willbearfruits/twofold/README.md

# TWOFOLD

A small USB sound card with an effects rack inside, a little screen and one knob.

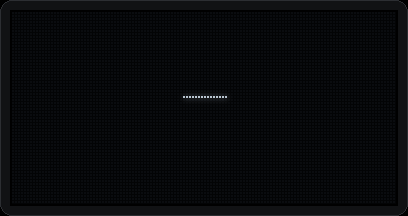
[picture p1: docs/img/ui/tour.gif]
TWOFOLD's screen as the firmware draws it: the volume page, the EQ, then each effect in turn


**[Flash it from your browser](https://willbearfruits.github.io/twofold/#flash)** ·
[Project page](https://willbearfruits.github.io/twofold/) ·
[Open the editor](https://willbearfruits.github.io/twofold/editor/) · [Get one](#get-one)

Plug it into a computer and it shows up as a stereo audio interface and a MIDI port, with nothing to install. Turn
the knob for volume. Press it to shape the sound with EQ, saturation, chorus, delay, plate reverb and a compressor,
each one drawn live on the screen. The same settings open in a web page that talks to the box over the USB cable.

## What it does

- **A sound card that needs no driver.** Stereo in and out at 48 kHz / 24-bit, plus a MIDI port, over one USB-C
  cable. It uses the audio driver built into Linux, macOS and Windows 10/11. (On the kit board the input is a
  microphone; a PCM1808 module adds a stereo line input.)
- **Effects in the box, not in the computer.** Five-band EQ, saturation, chorus, stereo or ping-pong delay, plate
  reverb and a compressor, then a safety limiter that keeps the output from clipping.
- **Easier listening.** Loudness compensation keeps the bass as you turn the volume down. Headphone crossfeed takes
  the hard edges off wide stereo mixes.
- **Hear yourself at once.** Direct monitoring mixes the input into the output without the trip through the
  computer, dry or through the effects.
- **One knob, one screen.** The EQ curve is drawn from the real filters over a live spectrum, and every effect has
  its own animation. Eight presets live on the box. (The GIF above is the firmware's own drawing code, run on a
  computer by the UI simulator.)
- **An editor in the browser.** Every setting, the meters, the presets and the MIDI map, in Chrome or Edge, over the
  USB cable. No WiFi, no app.
- **MIDI control.** Every parameter has a MIDI CC you can remap, and the knob can act as a MIDI controller.
  Bluetooth MIDI is there if you switch it on.
- **Quiet by default.** WiFi and Bluetooth stay completely off ("Studio Mode") until you ask for them.

TWOFOLD runs on the [ESP32-S3 SuperMini kit](https://github.com/willbearfruits/esp32-s3-supermini-kit), the same board
as [Samplooler](https://github.com/willbearfruits/samplooler), the looper you play by tilting it. One built board can
be flashed as either, and back again. [RING](https://github.com/willbearfruits/ring), a Raspberry Pi instrument, picks a
TWOFOLD up automatically as its sound card when one is plugged in.

## Get one

- **Buy one.** Built by hand in Haifa. There is no list price: write and ask, by
  [email](mailto:Dogme84@gmail.com?subject=TWOFOLD) or [WhatsApp](https://wa.me/972539263808). It is the same board as
  Samplooler, so ask for either, or both.
- **Build one in the workshop.** The [ESP32 workshop](https://willbearfruits.github.io/serious-shit/workshop-esp32.html):
  7 meetings at MEZO, Sirkin 3, Haifa · 2,200 ₪ · kit included · up to 8 people · 4 hours a week of open lab between
  meetings. You leave with a board that runs TWOFOLD and Samplooler.
- **Build it yourself.** Everything is open. Wire the modules from the [parts list and wiring](#hardware) below, or
  follow the kit's [assembly guide](https://github.com/willbearfruits/esp32-s3-supermini-kit/blob/main/docs/assembly/README.md):
  a kit board runs TWOFOLD unchanged.

## Flash it

You need a built board and a USB-C cable.

1. **From the browser** (Chrome or Edge on a computer): hold the board's **BOOT** button while you plug it in, then
   let go. Open the [flasher](https://willbearfruits.github.io/twofold/#flash), press **Connect and flash** and pick
   the port. When it says done, unplug and plug in again.
2. **Or with esptool:** download `twofold-v1.0.2-full.bin` from
   [Releases](https://github.com/willbearfruits/twofold/releases), enter the bootloader the same way, then

   ```sh
   esptool.py --chip esp32s3 -p /dev/ttyACM0 -b 460800 write_flash 0x0 twofold-v1.0.2-full.bin
   ```

   (Windows: `COMx`; macOS: `/dev/cu.usbmodem*`.)

Then:

- Your computer shows an audio device and a MIDI port called **TWOFOLD**. Pick it for input and output and set the
  sample rate to 48 kHz.
- On the kit board the input is the INMP441 microphone, which is mono on the left channel: set
  **GAIN → INPUT → LEFT** to hear it in both ears.
- For the editor, open **https://willbearfruits.github.io/twofold/editor/** in Chrome or Edge and press
  **Connect over USB**. On Linux, install the udev rule once:
  `sudo cp tools/99-twofold.rules /etc/udev/rules.d/ && sudo udevadm control --reload`, then replug. Windows and
  macOS should need nothing (not tested yet, see Status).
- The one-page guide for people who get a unit: [docs/QUICKSTART.md](docs/QUICKSTART.md).

Once TWOFOLD is on the board, updates need no buttons: `tools/flash.sh` asks the running firmware to reboot into
the bootloader, or, with WiFi on, the editor's **Device → Firmware** takes the `-ota.bin` file and rolls back by
itself if the new firmware fails.

## Status

Version 1.0.2, a release for testers. Tested on the ESP32-S3 SuperMini board, on Linux: USB audio in and out and
MIDI, two hours of playback with no dropouts, WiFi and Bluetooth running together, firmware updates over WiFi with
automatic rollback, hands-free flashing, and crash reports over USB. The DSP is checked by a test suite on a
computer ([results](docs/test-results/dsp_tests.md)).

Not tested yet: Windows and macOS (the device uses their built-in drivers, so it should work, but nobody has listened
on them yet), the stereo line input (PCM1808) and the low-jitter clock mode, measured noise and distortion through
real converters, and the printed case. It still uses Espressif's USB vendor ID with a placeholder product ID. The full
list is under [Needs real hardware to confirm](#needs-real-hardware-to-confirm). Reports of builds, good or bad, are
welcome in the issues.

---

## Inside

A 2-in / 2-out USB audio interface on the ESP32-S3: class-compliant UAC2 at 48 kHz / 24-bit plus USB-MIDI, an
onboard 32-bit float DSP chain, and a 128×64 OLED with one encoder. Radios are off by default ("Studio Mode").

| | |
|---|---|
| Audio | UAC2 async (explicit feedback), 48 kHz, 24-bit in 4-byte subslots, stereo in + out, driverless on Linux / macOS / Windows 10+ |
| DSP | 5-band parametric EQ (SVF/biquad hybrid) → saturation (2× oversampled) → chorus/ensemble → stereo/ping-pong delay → plate reverb → bus compressor → monitor blend → loudness compensation (ISO 226) → headphone crossfeed → volume → lookahead safety limiter → TPDF dither |
| Monitoring | zero-USB-latency direct monitor crossfade, dry or through the FX |
| Control | EC11 encoder (PCNT, accelerated), USB-MIDI CC (mappable), the web editor over **USB** (WebUSB/WinUSB, no radio) or opt-in WiFi (+ OTA), opt-in BLE-MIDI |
| Display | custom pixel fonts, live EQ curve from the real biquad coefficients + spectrum, per-effect visualisations, 60 fps tweened motion |
| Persistence | settings, MIDI map and 8 presets in NVS, written only in audio-safe windows |

Docs: [PLAN.md](PLAN.md) (architecture, clocking, budgets, every assumption and deviation) ·
[wiring](docs/wiring.md) · [clock analysis](docs/clocking/clock_jitter.md) · [DSP test results](docs/test-results/dsp_tests.md) ·
[UI design](docs/img/ui/) · [enclosure](docs/enclosure.md) · [web API](firmware/components/net/API.md) · [tools](tools/README.md) ·
[quick start](docs/QUICKSTART.md)

## Hardware

### BOM
| qty | part | notes |
|---|---|---|
| 1 | ESP32-S3 SuperMini (ESP32-S3FH4R2, 4 MB flash, 2 MB PSRAM) | native USB-C on GPIO19/20; tested target (flashed, enumerates) |
| 1 | PCM5102A module ("GY-PCM5102", purple) | XSMT bridged H, FMT=L, FLT=L, DEMP=L, SCK=GND |
| 1 | INMP441 I2S microphone (kit input) **or** PCM1808 line-in module | PCM1808: FMT=0, MD1=MD0=0 (slave, MCLK from GPIO21) or 1/1 (master, low-jitter mode) |
| (1) | MAX98357A I2S speaker amp (kit) | enabled via GPIO11 |
| 1 | 0.96" 128×64 I2C OLED (SSD1306 or SH1106, 4-pin, 0x3C) | controller selectable in Kconfig and at runtime (Settings → OLED) |
| 1 | EC11 encoder with switch, 15 mm D-shaft | 2 × 10 nF from A/B to GND recommended |
| 2 (3) | 3.5 mm stereo panel jacks (PJ-392 class, M6 bushing) | inputs (+ output if `output_jack="panel"`) |
| (1) | 12.288 MHz 3.3 V CMOS oscillator (SiT1602 / ECS-2520MV class) + 2 × 33 Ω | low-jitter mode only |
| | analog supply parts: see *Noise mitigation* | |
| | enclosure hardware: 4 × M3×20, 4 × M3 heat-set inserts, M2 screws, 4 bumpons | [docs/enclosure.md](docs/enclosure.md) |

### Wiring
All pins live in one header, [`board_config.h`](firmware/components/board/include/board_config.h). The full tables
(per module, power, strapping, both clock modes, ASCII diagrams) are generated from it into
[docs/wiring.md](docs/wiring.md) by `tools/gen_wiring.py`.

| GPIO | signal | connects to | notes |
|---|---|---|---|
| 7 | I2S BCK | PCM5102A BCK, INMP441 SCK, MAX98357A BCLK (or PCM1808 BCK) | input in low-jitter mode |
| 8 | I2S LRCK | PCM5102A LCK, INMP441 WS, MAX98357A LRC (or PCM1808 LRC) | input in low-jitter mode |
| 9 | I2S DOUT | PCM5102A DIN, MAX98357A DIN | |
| 10 | I2S DIN | INMP441 SD (or PCM1808 DOUT) | |
| 11 | AMP SD | MAX98357A SD | high once clocks are stable (pop-free start) |
| 12 / 13 | I2C SDA / SCL | OLED | shared with the kit's IMU/ToF |
| 4 / 5 / 6 | ENC A / B / SW | EC11 (C and switch leg → GND) | internal pull-ups |
| 21 | I2S MCLK | PCM1808 SCKI (only if fitted) | 12.288 MHz, internal clock mode |
| 48 | status LED | onboard RGB LED | |

This is the same wiring as the kit and Samplooler builds, so an existing kit board runs TWOFOLD unchanged.
GPIO1/2/3 stay with the kit's joystick. Avoided: strapping 0/3/45/46, USB 19/20, UART0 43/44.
The kit's input is the INMP441 microphone (mono, left slot): set **Gain → INPUT → LEFT** to hear it in both ears.
PCM5102A SCK: **GND** in internal mode (its PLL locks to BCK), **oscillator** in low-jitter mode. XSMT is bridged high
(set `BOARD_PIN_DAC_XSMT` to a free GPIO if you want a hardware soft-mute during boot).

### Enclosure
[`enclosure/twofold.scad`](enclosure/twofold.scad) is a parametric two-part wedge case with a knob, collision checks
and ready STLs ([docs/enclosure.md](docs/enclosure.md)). It was drawn around the Waveshare ESP32-S3-Zero, the board
TWOFOLD started on, and has not been printed yet. On the SuperMini kit, the board lives in the kit's own case.

## Clocking

The ESP32-S3 has no APLL, so I2S MCLK comes from a fractional divider. IDF 5.5 offers PLL_F160M, XTAL and EXTERNAL.

* **Internal mode (default):** ESP32 is I2S master, PLL_F160M → MCLK 256·fs = 12.288 MHz (divider 13 + 1/48),
  BCK = MCLK/4 exactly. The divider's error is a deterministic pattern repeating at **256 kHz**, far out of band.
  `tools/clock_jitter.py` models the IDF divider and gives 1.80 ns rms BCK jitter. That limits a full-scale 20 kHz
  sine to 72.9 dB in the raw case; after the PCM1808 decimation filter the in-band limit is 137.9 dB, and the
  PCM5102A's PLL (SCK = GND) filters what it sees. XTAL as a source is worse: 64 kHz pattern, 4× larger steps.
  Full analysis: [docs/clocking/clock_jitter.md](docs/clocking/clock_jitter.md).
* **Low-jitter mode** (`idf.py menuconfig` → TWOFOLD board → Audio clock mode → Low-jitter): a 12.288 MHz
  oscillator drives PCM1808 SCKI and PCM5102A SCK through 33 Ω resistors. The PCM1808 is I2S master (MD1=MD0=1)
  and the ESP32-S3 (TX + RX) and PCM5102A are slaves. No fractional division anywhere.
* **One clock domain:** one I2S peripheral in full duplex; TX and RX share BCK/LRCK in both modes.
* **USB feedback follows whichever clock is master:** the audio task is paced only by the I2S clock and drains
  and fills TinyUSB's FIFOs. OUT uses `AUDIO_FEEDBACK_METHOD_FIFO_COUNT` and IN uses level-based 47/48/49-frame
  flow control, so both loops track the real converter clock with nothing mode-specific to calibrate.

## Building from source

Requires ESP-IDF **v5.5.x**. Components (TinyUSB 0.21, esp-dsp, led_strip, mdns) come from the registry
(`firmware/dependencies.lock` pins them).

```sh
. ~/esp/esp-idf/export.sh
cd firmware
idf.py set-target esp32s3      # once
idf.py menuconfig              # optional: TWOFOLD board → clock mode, OLED type, I2C 1 MHz, encoder direction
idf.py build
```

Flashing: TinyUSB owns the native USB port at runtime, so enter the ROM bootloader first. Hold **BOOT**, tap
**RST**, release BOOT; the board enumerates as a USB-serial/JTAG device (`303a:1001`). Then:

```sh
idf.py -p /dev/ttyACM0 flash
```

Press RESET to start; it enumerates as **TWOFOLD** (audio + MIDI). Logs come out of UART0 (GPIO43 TX / GPIO44 RX,
115200). Later updates can also go over WiFi: Device → Firmware in the web editor (OTA, A/B partitions).

Host-side tools (no hardware needed):

```sh
host/dsp_tests/run.sh          # DSP test-suite -> docs/test-results/dsp_tests.md + plots
host/sim/run.sh                # UI simulator -> docs/img/ui/ (every screen, transitions, tour.gif)
python3 host/web_mock/server.py --port 8000   # the web editor with a fake device
enclosure/check.sh             # enclosure collision checks + STL export
python3 tools/loopback.py --selftest          # measurement-suite self-test (synthetic device)
```

### Releases
`tools/release.sh [version]` builds `dist/twofold-<version>/`: a merged image for `esptool write_flash 0x0`, the
app-only OTA image, the editor page for USB use, the udev rule, checksums, `FLASH.md` and
[docs/QUICKSTART.md](docs/QUICKSTART.md) (the one-page guide for people who get a unit). Tag releases
(`git tag -a v1.0.0`) so the version shows in ABOUT and `/api/info`. The bundle goes to
[GitHub Releases](https://github.com/willbearfruits/twofold/releases), not into the repository. The browser flasher
serves its own copy of the full image from [docs/flash/](docs/flash/), and [docs/editor/](docs/editor/) holds a copy of
the editor: update both, and `docs/flash/manifest.json`, with each release.

## Hands-free flashing, status and crash reports over USB
`tools/flash.sh` asks the running firmware (USB-MIDI SysEx) to reboot into the ROM download mode, flashes, and starts
the app again: no BOOT/RST buttons after the first flash. `tools/twofold_status.sh` reads CPU per DSP block, xruns,
USB FIFO/feedback, heap and stack headroom; `tools/crash_report.sh` reads the last panic (reason + backtrace, kept in
RTC memory) and symbolises it. The OLED also shows e.g. "CRASH: WIFI START" after an abnormal reset.

## The editor without WiFi
The web editor talks to the device over its USB vendor interface too. Open
[willbearfruits.github.io/twofold/editor/](https://willbearfruits.github.io/twofold/editor/) in Chrome or Edge (or
`firmware/components/net/web/index.html` from disk, or any https host) and press **Connect over USB**. Windows installs
WinUSB by itself (MS OS 2.0 descriptor); on Linux install `tools/99-twofold.rules` once (`sudo cp tools/99-twofold.rules
/etc/udev/rules.d/ && sudo udevadm control --reload`, replug). `tools/twofold_usb.py get /api/state` does the same
from a shell. Firmware updates from the editor need WiFi; over USB, use the flasher or `tools/flash.sh`. Protocol:
[API.md](firmware/components/net/API.md).

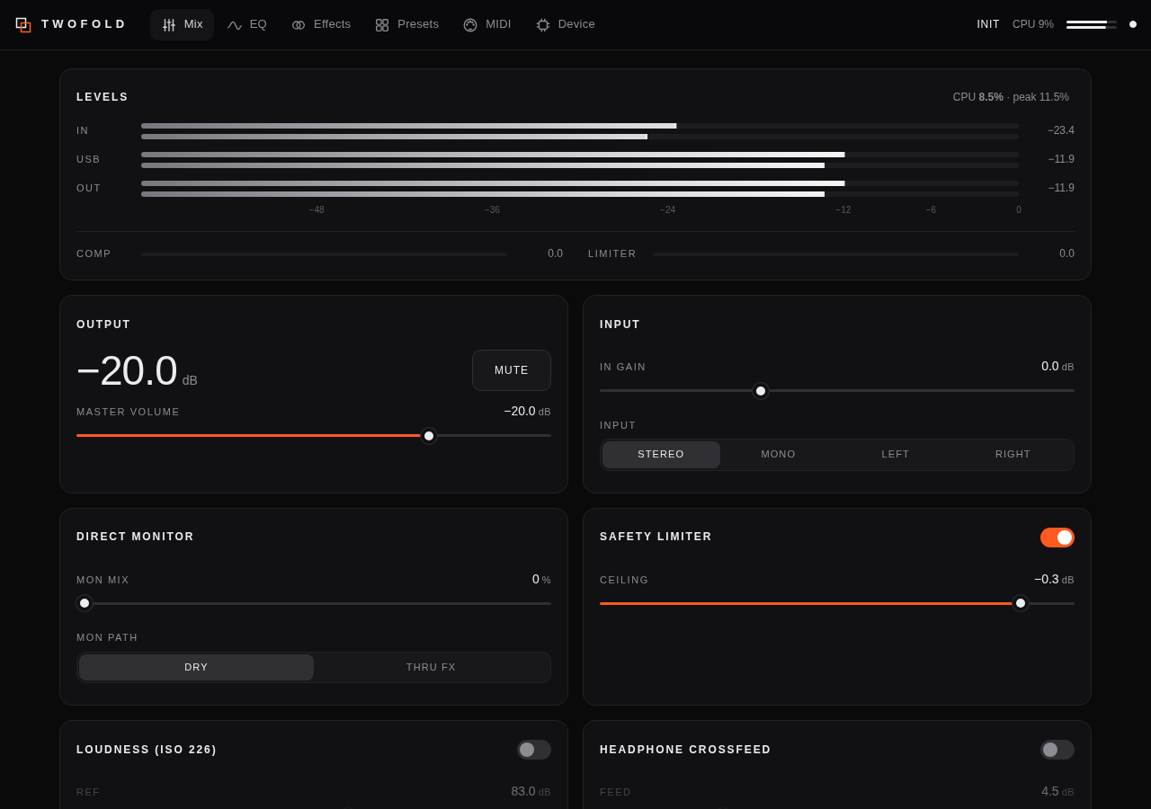
[picture p2: docs/img/web/desktop_mix.png]
The web editor's Mix page: level meters, output, input, direct monitor and safety limiter


## Using it
* **Home:** turn = master volume (accelerated), press = menu, double-press = mute, long-press = back (everywhere).
* **Menu:** EQ · Gain · Effects · Network · Bluetooth · Presets · Settings. The hidden diagnostics screen:
  Settings → About, hold the button for 3 s. It shows CPU % per DSP block (avg/max), xruns, USB FIFO + feedback,
  heap, measured fs and clock mode.
* **Studio Mode** is the default: WiFi and BLE are fully de-initialised (drivers, netifs, tasks and memory released).
  The home screen shows a STUDIO badge. Settings → Radios = RESTORE brings back the last radio state at boot.
* **WiFi** (Network → WiFi on): with no saved network the device starts an access point `TWOFOLD-XXXX`.
  The password is shown on the OLED, and a captive portal opens the setup page. Afterwards it joins your network
  as `twofold.local`. TX power is reduced and modem sleep is enabled in station mode.
* **Listening features** (Effects → Loudness / Crossfeed, also in the web editor): loudness compensation follows the
  volume knob with ISO 226:2003 contours (reference level and amount adjustable); headphone crossfeed (BS2B-style,
  feed level and cutoff, 220 µs ITD) keeps mono bit-exact.
* **Bluetooth:** BLE-MIDI for remote control only. **There is no Bluetooth audio:** the ESP32-S3 has
  Bluetooth LE only, no Bluetooth Classic, so no A2DP. Audio goes over USB. The menu help text says the same.
* **MIDI:** every parameter has a stable key and an optional CC. The defaults are in
  [`params_table.h`](firmware/components/params/include/params_table.h), e.g. CC7 volume, CC20–24 EQ gains,
  CC102–119 effects. The map can be edited in the web editor (MIDI page). Device-side changes are echoed as CC.
  The knob can also act as a MIDI controller (Settings → Knob mode).

## Noise mitigation (hardware)
The radios are the main noise risk in a USB-powered device with converters and an RF SoC on one supply.
Hence Studio Mode, but the hardware matters too:
* **Separate analog supply:** feed the PCM1808 and PCM5102A analog rails (AVDD / VCC) from their own low-noise LDO
  (e.g. TPS7A2033 / LP5907, ≥ 70 dB PSRR at 1 kHz) off USB 5 V, not from the board's small 3V3 regulator.
  Most modules have an onboard LDO; feed it from a filtered 5 V branch.
* **Ferrite bead + bulk:** 5 V → ferrite bead (600 Ω @ 100 MHz, e.g. BLM18PG601) → 47–100 µF low-ESR bulk
  at each converter module. Add 10 µF + 100 nF at each module's supply pins, and 100 nF at the oscillator.
* **Ground:** star the grounds at the USB connector (or one point near the DAC). Run the I2S lines with their
  ground return beside them and keep them short (< 10 cm, ideally twisted with GND). Series 22–33 Ω on BCK/LRCK/MCLK
  at the driver damps ringing. Keep the jack grounds on the analog ground, not the chassis.
* **Antenna keep-out:** the S3 board's antenna end faces into an empty zone, away from both converter
  modules and their analog wiring. The enclosure enforces this with its `antenna-keepout` check. Keep metal and cables
  ≥ 10 mm from the antenna.
* **Firmware side:** reduced TX power, modem sleep, radios fully off by default, and the BLE/WiFi stacks on core 0.
  `tools/loopback.py --label studio/wifi --report` measures the difference (noise floor, THD+N).

## Measured results

**DSP** (`host/dsp_tests/run.sh`, the real engine through its public API, run on a computer; full table and plots in
[docs/test-results/dsp_tests.md](docs/test-results/dsp_tests.md)):

| test | result |
|---|---|
| EQ vs analytic RBJ (3 configs incl. 20 Hz shelves, Q = 10) | max error 0.025 dB (limit 0.05) |
| EQ low-frequency precision vs ideal double filter | −119 dBFS residual, 95 dB below the signal (float biquads: −79 dBFS) |
| loudness (ISO 226) at volume −40 dB | +15.5 dB at 50 Hz (formula +16.2), 0.0 at 1 kHz; 1 kHz contour exact to 0.01 dB |
| crossfeed | mono bit-identical; L→R −4.9 dB at 100 Hz for 4.5 dB feed, −31 dB at 10 kHz |
| limiter, +12 dB overs (sine, square, bursts, fs/4) | peak −0.300 dBFS at a −0.30 ceiling; bit-identical to limiter-off below threshold |
| plate reverb RT60 vs setting (1.0 / 2.2 / 6.0 s) | 0.96 / 2.02 / 5.16 s; L/R tail correlation < 0.02 |
| delay taps (free 250 ms, sync 1/4 & 1/8D @120 BPM, stereo / ping-pong) | spacing exact to ±1 sample, ping-pong alternation correct |
| saturation aliasing, drive ≤ 12 dB, 5–9 kHz | worst alias −137 to −143 dBc (naive tanh: −45 to −67 dBc) |
| TPDF dither | 0.526 LSB rms error, mean 0.0002, L/R corr 0.0015 |
| bit-perfect paths | DAC at unity/flat chain and record at unity: 0 LSB error |
| click test, all 84 parameters def→max→min→def, presets, soft mute | worst 3.2 dB (limit 6 dB); presets 0.0 dB |

**CPU (ESP32-S3, 240 MHz), measured on the board** with `tools/twofold_status.sh` (every DSP block is bracketed with
cycle counters; also on the diagnostics screen):

| | all effects off | **all effects on**, EQ flat | all effects on + 5 EQ bands at ±18 dB | + WiFi AP + BLE |
|---|---|---|---|---|
| average | 9 % | **53 %** (budget < 60 %) | 60 % | unchanged (radios run on core 0) |
| worst block | 12 % | 59 % | 68 % | |

Per block with everything on: reverb 15.7, saturation 14.0, EQ 7.5 (5 active bands; 0.5 when flat), chorus 6.7,
delay 6.1, comp 4.0, input 2.2, dither 2.1, output + loudness + crossfeed + limiter 1.8 (% of one core).
The first on-device measurement was 130 %. The fixes, each measured on the board, were:
* ESP-IDF builds with `-fno-builtin-memcpy`, so the `memcpy`-based float punning in the DSP math helpers turned into a
  ROM call per sample. Using `__builtin_memcpy` and `__builtin_fabsf` (`abs.s`) took it from 128 % to 71 %.
* parameters are re-read only on change;
* the half-band filters and chorus taps were restructured so the in-order FPU has independent work;
* the chorus moved to mid/side lines with one tap per voice;
* saturation oversampling went from 4× to 2× (see the limitations below).

**EQ precision.** Float biquad coefficients lose precision for low-frequency / high-Q bands (the poles sit at
a2 ≈ 0.9998). Measured against an ideal double-precision filter (20 Hz shelf +18 dB, 30 Hz Q 10 +18 dB, 60 Hz Q 8 −18 dB):
float TDF-II biquads −79 dBFS residual (55 dB under the signal); the trapezoidal SVF now used for such bands −119 dBFS
(95 dB under). Bands with f < 500 Hz or f/Q < 100 Hz get the SVF, the rest the 3× cheaper biquad.

**Memory** (`idf.py size`, WiFi + BLE + httpd linked): image 1.40 MB (31 % of each 1.94 MB OTA slot free);
static DIRAM 217 KB used / 124 KB left, of which 58 KB is DSP code placed in IRAM. DSP buffers at runtime:
reverb tank ~73 KB (short lines internal; the long delay lines go to PSRAM if internal free RAM would drop below the
96 KB reserved for stacks and radios), chorus 16 KB internal, delay 2 × ~300 KB + pre-delay in PSRAM. The boot log
prints the exact internal/PSRAM split.

**UI:** render 6 µs/frame average on the host. All screens: [docs/img/ui/contact_sheet.png](docs/img/ui/contact_sheet.png).

## Known limitations
* 48 kHz only (on the S3 PLL, 44.1 kHz would be equally fractional; OS resamplers handle it). A 96 kHz variant is on the roadmap.
* Saturation runs at 2× oversampling to fit the CPU budget: aliasing stays at −138 to −152 dBc at musical drive (≤ 12 dB),
  but at extreme settings (24 dB drive on a −6 dBFS 9–13 kHz sine) it reaches −19 to −22 dBc. `menuconfig` → TWOFOLD DSP
  offers 4× (−33 to −47 dBc there, about +13 % CPU).
* WiFi (setup AP + web) and BLE together use ~100 KB of internal RAM; both run at once with ~30 KB to spare (task
  stacks that never touch flash live in PSRAM, WiFi buffers trimmed). Each refuses to start, with a message, instead
  of crashing if that headroom is gone.
* The USB vendor interface uses the ESP32-S3's last free IN endpoint, and EP0 had to shrink to 32 bytes to fit the
  DWC2 FIFO; there is no room for a USB-network (NCM) interface next to UAC2 + MIDI.
* The reverb's wet signal is band-limited to ~10 kHz (24 kHz tank: an internal-RAM trade-off, see PLAN §14).
* Flash writes stall both CPUs on the S3, so settings are committed only in audio-safe windows (silence / no stream)
  or under a brief soft-mute for explicit saves. Unplugging within ~3 s of a change, while audio is playing, can lose
  that last change.
* OTA and WiFi credential saves soft-mute the audio while flash is written. An OTA image runs on probation
  (bootloader rollback): it is kept after 20 s of clean audio; if that has not happened within 3 minutes, or it
  crashes, the previous image returns.
* The VID is Espressif's (0x303A) with a placeholder PID. A product needs its own PID.
* OpenSCAD 2021.01 flags the lid STL as possibly non-manifold (coincident faces); slicers repair it on import.

## Needs real hardware to confirm
Verified on the SuperMini board: USB audio in/out and MIDI on Linux, 2 h of playback with every counter at 0 (xruns,
I2S errors), WiFi + BLE together, crash capture, hands-free flashing, OTA with rollback, the host test suite.
Still open:
1. Driverless streaming on macOS and Windows 10/11 (Linux verified: 48 kHz/24-bit async in + out, MIDI, 2 h with zero
   xruns), and hours-long drift-click-free playback measured (`tools/loopback.py --drift`). WebUSB/WinUSB on Windows and macOS.
2. Actual internal heap at boot, and WiFi + BLE enabled together without running out of internal RAM.
3. Loopback latency, frequency response, THD+N and noise floor, Studio Mode vs WiFi on (`tools/loopback.py`; the
   full loop needs the line-input ADC).
4. PCM1808 slave mode with the PLL-derived MCLK, and low-jitter mode with the PCM1808 as master.
5. OLED at 1 MHz I2C, SH1106 offset, brightness curve; encoder direction / counts per detent of your EC11.
6. The storage policy's audio-safe windows under real use, and flash auto-suspend if your flash supports it.
7. Enclosure fit with your modules (measure first: [checklist](docs/enclosure.md#measurement-checklist-calipers-before-printing)).

## Roadmap
Planned build-time variants, same board, details and the USB/CPU arithmetic in PLAN.md §15:
* **96 kHz** (`TWOFOLD_FS_96K`): same 12.288 MHz MCLK and jitter (128·fs), USB moves to 3-byte subslots because
  4-byte packing does not fit a Full Speed frame at 96 k in both directions. EQ, saturation (no oversampling needed),
  compressor, limiter, loudness and crossfeed stay; chorus, delay and reverb are off in this variant.
* **4 outputs** (`TWOFOLD_OUT4`): a second PCM5102A on its own data line, sharing BCK/LRCK with the first (I2S1 TX
  slaved to I2S0 through the GPIO matrix, one clock domain). The host sees a 2-in/4-out device at 48 k. Outputs 3-4
  route from a second USB bus, a copy of the main out, the dry monitor or the wet return.
* Not possible on one S3: both at once (4 out at 96 k exceeds the Full Speed frame budget). Effects at 96 k would need
  a second S3 as an I2S co-processor.

## Repository map
```
PLAN.md                     architecture, budgets, assumptions, deviation log
firmware/                   ESP-IDF project (idf.py build)
  components/board          board_config.h (all pins) + Kconfig (clock mode, OLED)
  components/params         parameter table (single source of truth), presets, MIDI map, serialisation
  components/dsp            portable float DSP engine (also compiled by the host tests)
  components/audio          I2S full duplex, both clock modes, audio task (core 1)
  components/usbdev         TinyUSB UAC2 + MIDI composite, feedback, USB-MIDI
  components/ui, gfx        portable UI + 1-bit graphics + custom fonts (also compiled by the simulator)
  components/display        SSD1306 / SH1106 driver, dirty-band flush
  components/input          PCNT encoder + debounced switch
  components/storage        NVS with audio-safe writes
  components/net, ble       WiFi / captive portal / web editor / OTA / USB vendor API, BLE-MIDI
  components/led            WS2812 status LED
  components/bootdiag       crash capture across resets, served over USB-MIDI SysEx
host/dsp_tests  host/sim  host/web_mock
tools/                      clock_jitter.py, loopback.py, gen_wiring.py, release.sh, flash.sh, status and USB tools
enclosure/                  twofold.scad, check.sh, stl/, renders/
docs/                       wiring, clocking, test results, UI images, web screenshots, enclosure, quick start
docs/index.html             the project page (GitHub Pages); docs/editor/ the hosted editor, docs/flash/ the flasher
```

## Licence

TWOFOLD is free software: GPL-3.0-or-later ([LICENSE](LICENSE)). That covers the firmware, the web editor, the
tools, the enclosure and the docs. The firmware is built on ESP-IDF, TinyUSB and other Espressif components;
[NOTICE.md](NOTICE.md) lists them and their licences.

---
Part of [Serious S.H.I.T.](https://willbearfruits.github.io/): instruments, tools and workshops made in Haifa by
Yaniv Schonfeld (Willbear). If this is useful to you, [support it on Patreon](https://www.patreon.com/Seriousshit).
