willbearfruits/twofold/docs/clocking/tie_pll_d2_512fs_48000.png

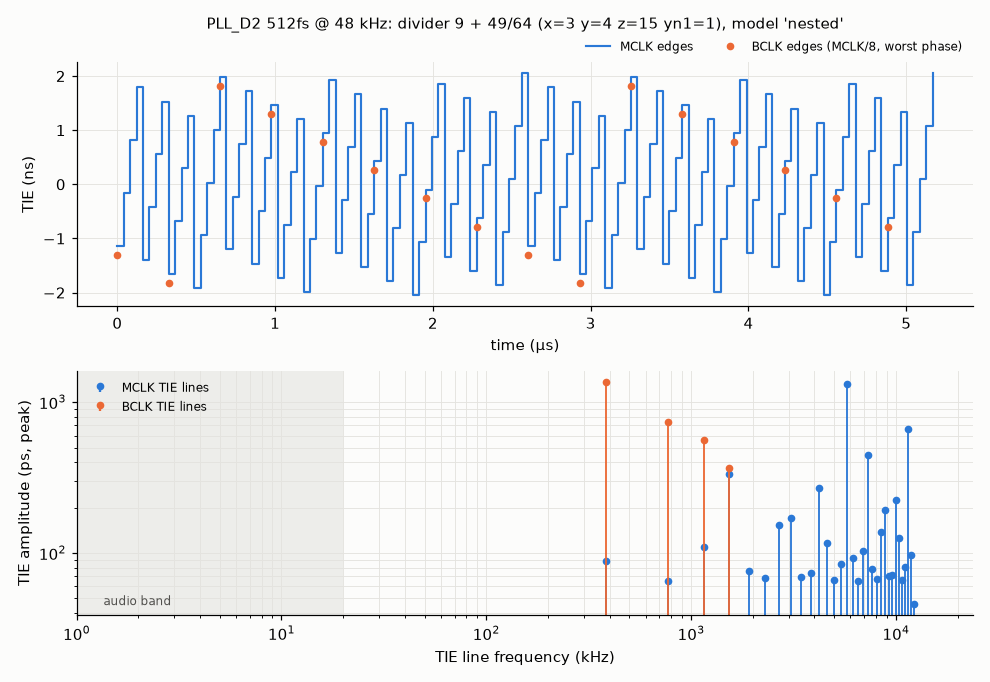
docs/clocking/tie_pll_d2_512fs_48000.png
