willbearfruits/twofold/docs/clocking/tie_pll_f160m_256fs_48000.png

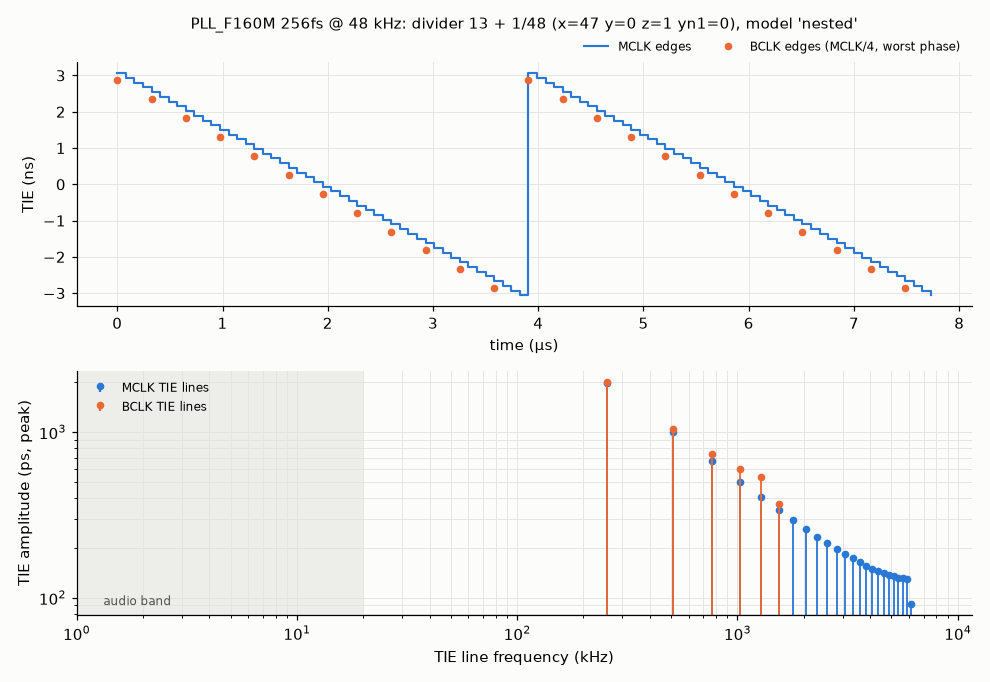
docs/clocking/tie_pll_f160m_256fs_48000.png
