willbearfruits/twofold/docs/clocking/tie_xtal_256fs_48000.png

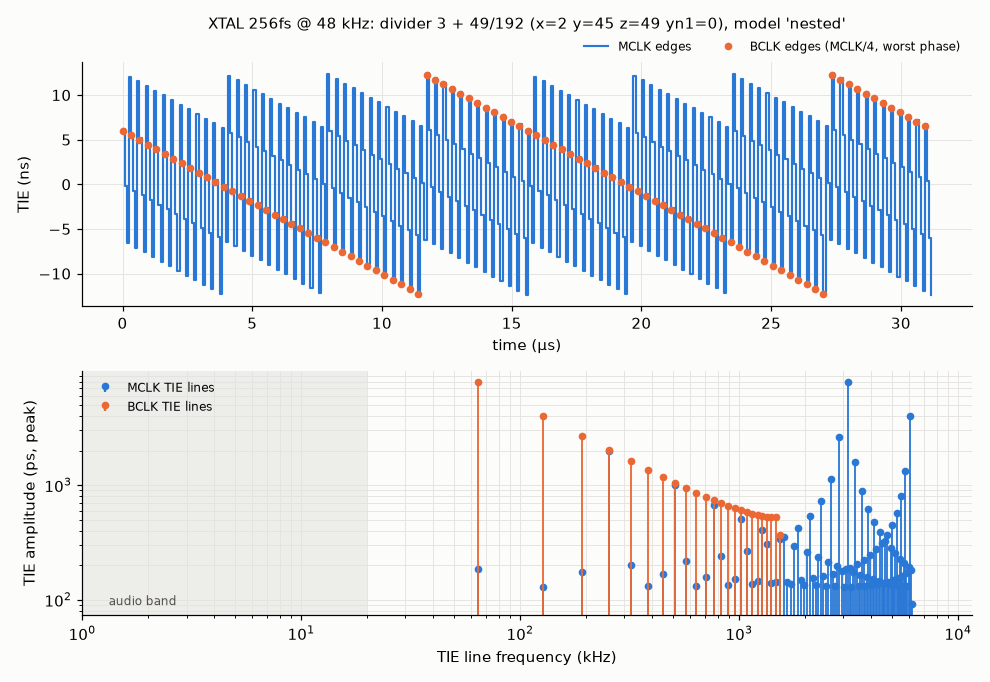
docs/clocking/tie_xtal_256fs_48000.png
