willbearfruits/twofold/docs/clocking/tie_xtal_384fs_48000.png

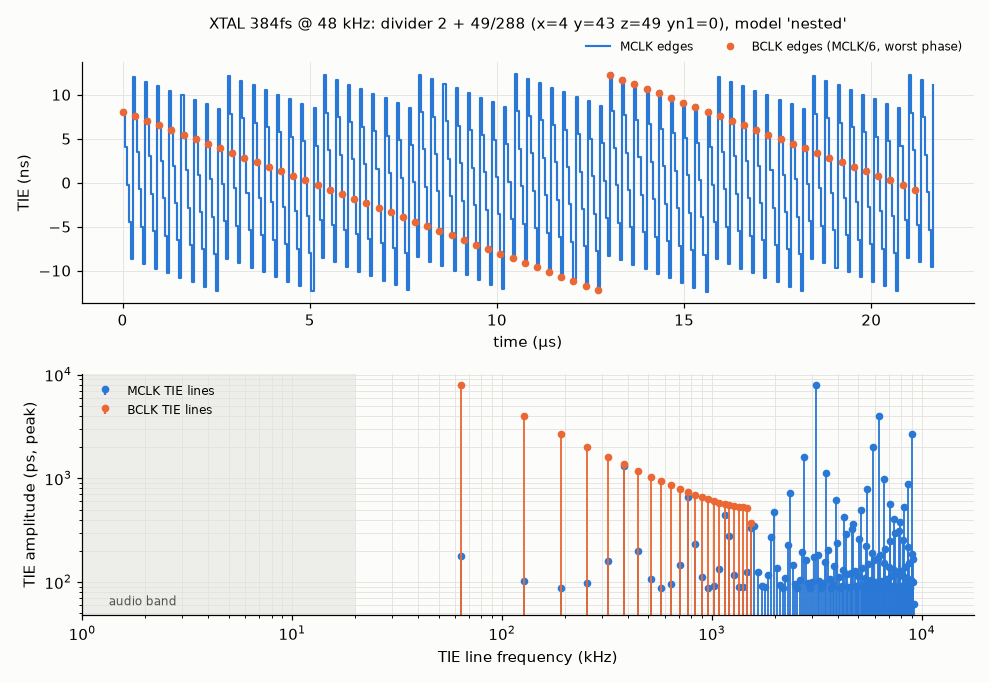
docs/clocking/tie_xtal_384fs_48000.png
