willbearfruits/twofold/docs/clocking/tie_xtal_512fs_48000.png

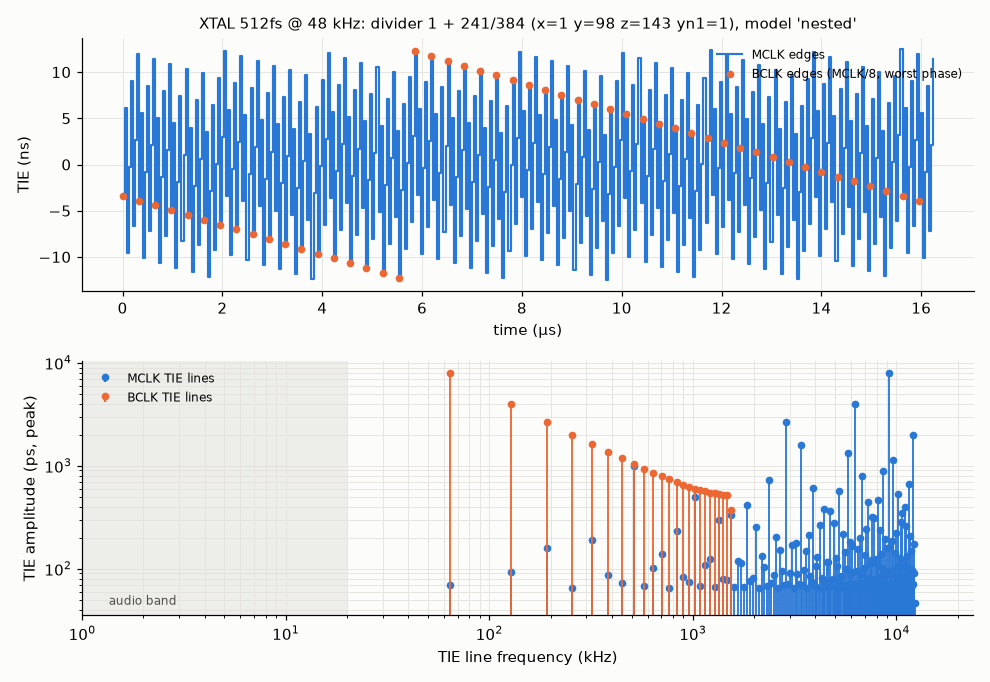
docs/clocking/tie_xtal_512fs_48000.png
