willbearfruits/twofold/docs/img/tour-poster.png

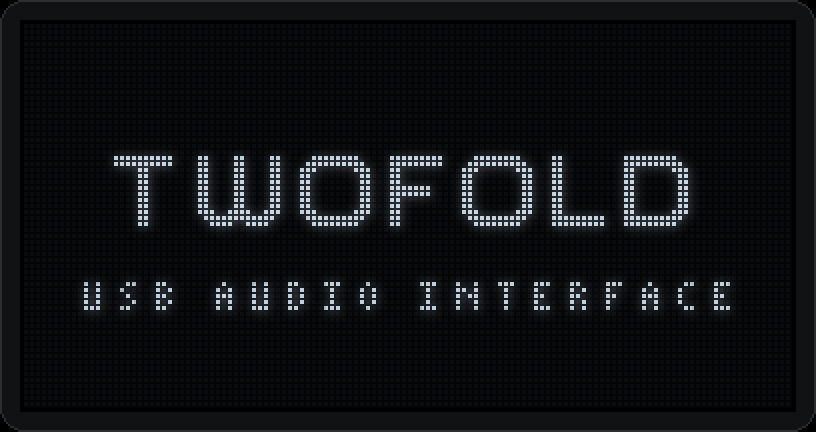
docs/img/tour-poster.png
