willbearfruits/twofold/docs/img/web/desktop_eq.png

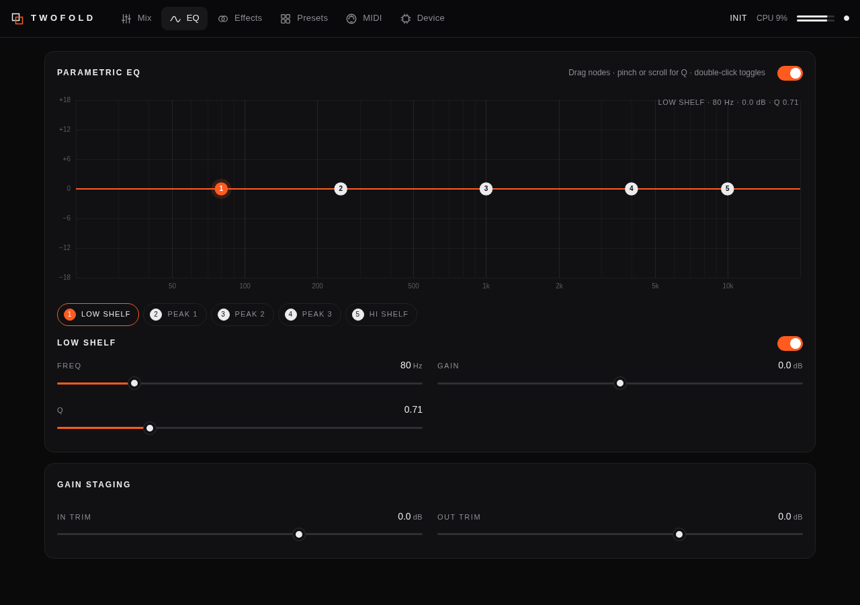
docs/img/web/desktop_eq.png
