willbearfruits/twofold/docs/img/web/phone_mix.png

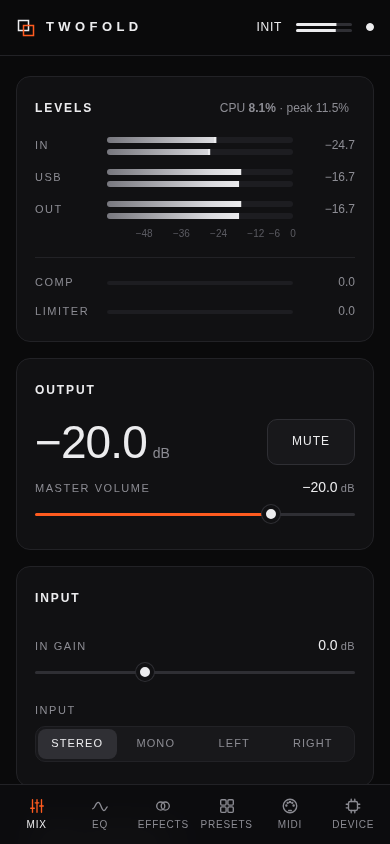
docs/img/web/phone_mix.png
