willbearfruits/twofold/enclosure/renders/exploded.png

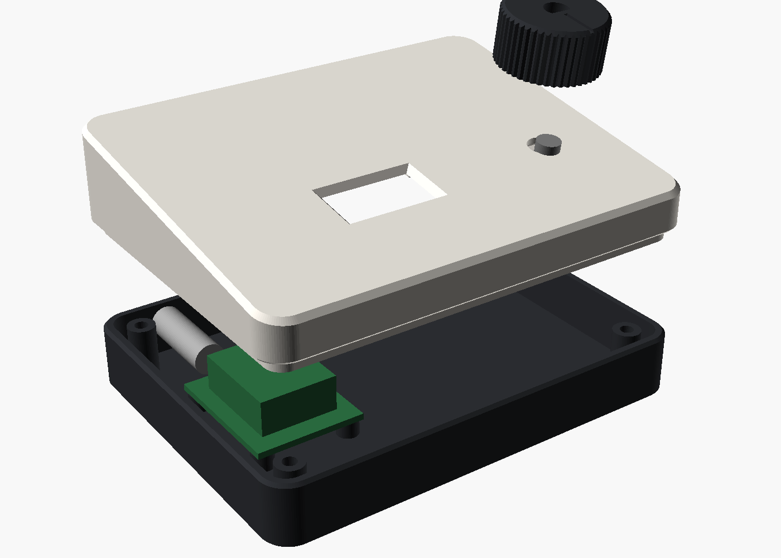
enclosure/renders/exploded.png
