willbearfruits/twofold/enclosure/stl/twofold_lid.stl

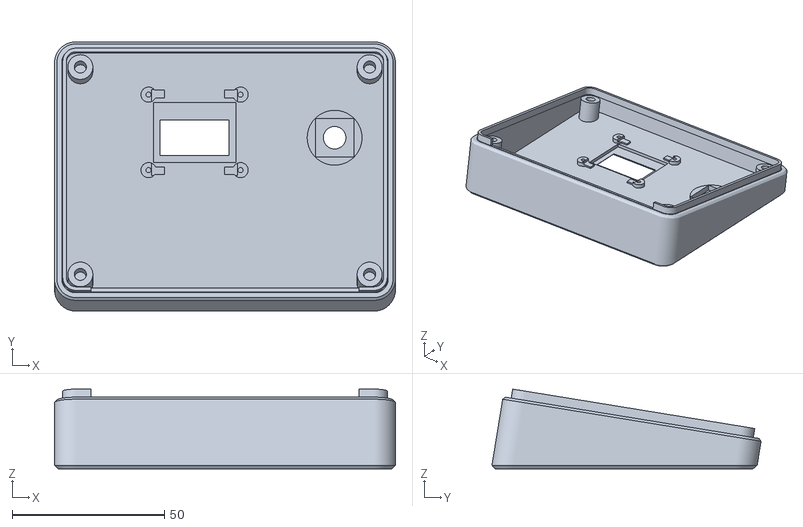
[picture p17: CAD file, 2026-10-04]
enclosure/stl/twofold_lid.stl
112.0 x 88.4 x 26.2
