willbearfruits/twofold/enclosure/stl/twofold_knob.stl

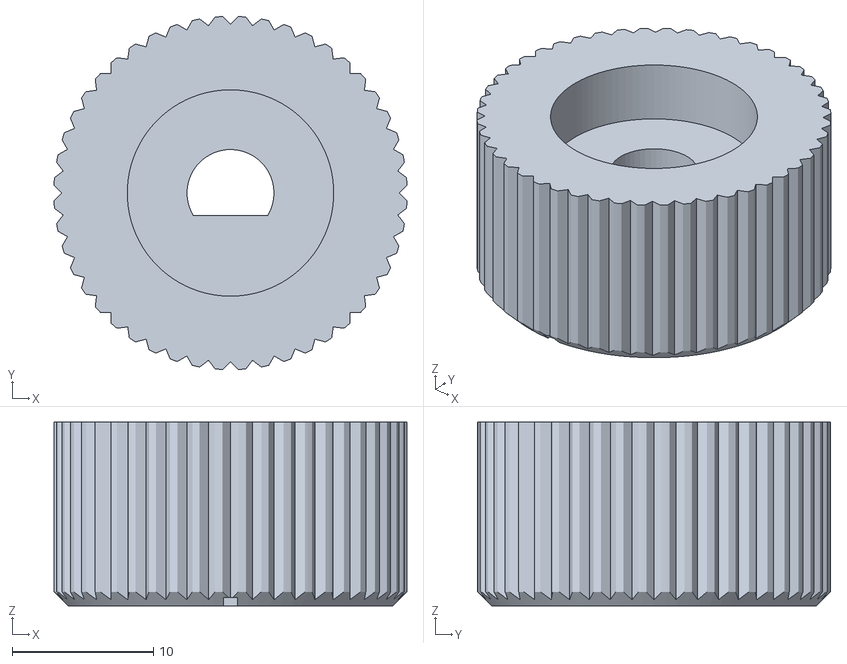
[picture p18: CAD file, 2026-10-04]
enclosure/stl/twofold_knob.stl
25.0 x 25.0 x 13.0
