willbearfruits/twofold/enclosure/stl/twofold_tray.stl

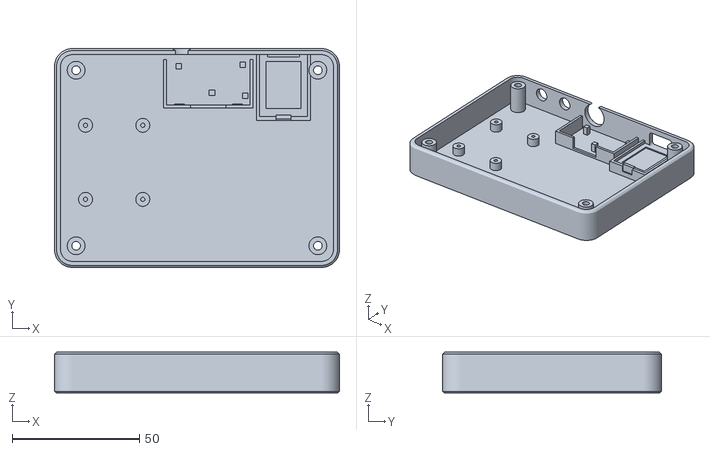
[picture p19: CAD file, 2026-10-04]
enclosure/stl/twofold_tray.stl
112.0 x 86.0 x 16.0
