willbearfruits/twofold/docs/wiring.md

# TWOFOLD wiring

<!-- GENERATED by tools/gen_wiring.py from firmware/components/board/include/board_config.h. Do not edit by hand: change the header's
     `/* PIN: signal | module pin | notes */` comments and re-run the script. -->

Board: ESP32-S3 SuperMini (kit wiring, same as gesture-recorder). Audio: 48 kHz, MCLK = 256·fs (12.288 MHz) in internal mode, external oscillator 12.288 MHz in low-jitter mode (PLAN.md §4).

## 1. SuperMini GPIO → modules

| GPIO | signal | connects to (module pin) | dir, internal clock | dir, ext. oscillator | notes |
|---|---|---|---|---|---|
| **GPIO4** | ENC A | EC11 A (CLK) | in (pull-up) | in (pull-up) | internal pull-up, 10 nF to GND recommended |
| **GPIO5** | ENC B | EC11 B (DT) | in (pull-up) | in (pull-up) | internal pull-up, 10 nF to GND recommended; EC11 C -> GND |
| **GPIO6** | ENC SW | EC11 switch | in (pull-up) | in (pull-up) | other switch leg -> GND, internal pull-up |
| **GPIO7** | I2S BCK | PCM5102A BCK<br>INMP441 SCK<br>MAX98357A BCLK (PCM1808 BCK) | out (BCK 3.072 MHz) | in (BCK from PCM1808) | output (internal) / input (ext osc) |
| **GPIO8** | I2S LRCK | PCM5102A LCK<br>INMP441 WS<br>MAX98357A LRC (PCM1808 LRC) | out (LRCK 48 kHz) | in (LRCK from PCM1808) | output (internal) / input (ext osc) |
| **GPIO9** | I2S DOUT | PCM5102A DIN<br>MAX98357A DIN | out | out | to DAC + speaker amp |
| **GPIO10** | I2S DIN | INMP441 SD (or PCM1808 DOUT) | in | in | from mic / ADC |
| **GPIO11** | AMP SD | MAX98357A SD | out | out | speaker amp enable: driven high after the clocks are stable |
| **GPIO12** | OLED SDA | OLED SDA | io (open drain) | io (open drain) | 4.7k pull-up to 3V3 (usually on module); shared with the kit's IMU/ToF |
| **GPIO13** | OLED SCL | OLED SCL | out (open drain) | out (open drain) | 400 kHz (1 MHz with CONFIG_TWOFOLD_I2C_FAST) |
| **GPIO21** | I2S MCLK | PCM1808 SCKI *(internal mode only)* | out (MCLK 12.288 MHz) | unused: GPIO left as input, not connected | only if a PCM1808 is fitted (internal clock mode, 256fs = 12.288 MHz); the kit's INMP441 needs none |
| **GPIO48** | LED | onboard RGB LED | out (RMT) | out (RMT) | on the SuperMini PCB, no wiring |

GPIO1/2/3 stay with the kit's joystick (unused by TWOFOLD). Avoid strapping pins 0/3/45/46, USB 19/20, UART0 43/44 (console); GPIO48 is the onboard RGB LED.

## 2. Per-module view

**EC11**

| module pin | GPIO | signal |
|---|---|---|
| A (CLK) | GPIO4 | ENC A |
| B (DT) | GPIO5 | ENC B |
| switch | GPIO6 | ENC SW |

**INMP441**

| module pin | GPIO | signal |
|---|---|---|
| SCK | GPIO7 | I2S BCK |
| SD (or PCM1808 DOUT) | GPIO10 | I2S DIN |
| WS | GPIO8 | I2S LRCK |

**MAX98357A**

| module pin | GPIO | signal |
|---|---|---|
| BCLK (PCM1808 BCK) | GPIO7 | I2S BCK |
| DIN | GPIO9 | I2S DOUT |
| LRC (PCM1808 LRC) | GPIO8 | I2S LRCK |
| SD | GPIO11 | AMP SD |

**OLED**

| module pin | GPIO | signal |
|---|---|---|
| SCL | GPIO13 | OLED SCL |
| SDA | GPIO12 | OLED SDA |

**PCM1808**

| module pin | GPIO | signal |
|---|---|---|
| SCKI | GPIO21 | I2S MCLK |

**PCM5102A**

| module pin | GPIO | signal |
|---|---|---|
| BCK | GPIO7 | I2S BCK |
| DIN | GPIO9 | I2S DOUT |
| LCK | GPIO8 | I2S LRCK |

Other module pins: PCM1808 FMT/MD0/MD1 and PCM5102A FLT/DEMP/FMT/SCK are strapped (section 4); EC11 C and the second switch leg go to GND; OLED VCC/GND per section 3.

## 3. Power and ground

| from | to | notes |
|---|---|---|
| board **5V** (USB VBUS) | PCM1808 module **+5V** (VCC) | analog supply; the module's LDO makes its 3.3 V. If your module has *no* LDO, feed its 3.3V pin from board 3V3 instead |
| board **5V** (USB VBUS) | PCM5102A module **VIN** | GY-PCM5102 has its own LDOs (3.3–5 V input); 5 V gives the cleanest AVDD |
| board **3V3** | OLED **VCC** | |
| board **3V3** | 12.288 MHz oscillator **VDD** and **OE/ST** *(low-jitter mode only)* | 100 nF + 1 µF ceramic right at the oscillator VDD pin |
| board **GND** | PCM1808 GND, PCM5102A GND, OLED GND, EC11 C (common) and switch leg, oscillator GND | star ground at the board GND pin; keep the audio modules' grounds short and together, run the USB/digital return away from the analog jacks |
| — | PCM1808 module 3.3V pin | leave open when the module regulates its own 3.3 V (do not back-feed the module LDO) |

Logic levels: all I2S/control signals are 3.3 V (ESP32-S3 IO, PCM1808 DVDD = 3.3 V, PCM5102A DVDD = 3.3 V).
Signal integrity: keep MCLK/BCK wires short (< 10 cm) and twisted with a ground wire; a 22–33 Ω series resistor at
the driving end of MCLK and BCK (S3 GPIO4/5 in internal mode) damps ringing on flying leads.

## 4. Converter strapping, both clock modes

| converter pin | internal clock (default) | low-jitter mode (`CONFIG_TWOFOLD_CLOCK_EXT_OSC`) | meaning |
|---|---|---|---|
| PCM1808 **FMT** | GND (0) | GND (0) | I2S data format |
| PCM1808 **MD0** | GND (0) | 3V3 (1) | MD1:MD0 = 00: slave; 11: master, SCKI = 256·fs |
| PCM1808 **MD1** | GND (0) | 3V3 (1) | (see MD0) |
| PCM1808 **SCKI** | ← S3 GPIO21 (MCLK 12.288 MHz) | ← oscillator via **33 Ω** | system clock |
| PCM1808 **BCK / LRC** | inputs ← S3 GPIO7 / GPIO8 | **outputs** → S3 GPIO7 / GPIO8 and PCM5102A BCK / LCK | bit / frame clock |
| PCM5102A **FMT** | GND (L) | GND (L) | I2S data format |
| PCM5102A **FLT** | GND (L) | GND (L) | normal-latency FIR filter |
| PCM5102A **DEMP** | GND (L) | GND (L) | de-emphasis off |
| PCM5102A **XSMT** | 3V3 (H) — bridged on the kit board | 3V3 (H) | high = play. Optional: wire it to a free GPIO and set BOARD_PIN_DAC_XSMT for a hardware soft-mute at boot |
| PCM5102A **SCK** | **GND** (internal PLL locks to BCK) | ← oscillator via **33 Ω** (PLL bypassed) | system clock |

GY-PCM5102 boards set FLT/DEMP/XSMT/FMT with solder jumpers H1L–H4L on the back: bridge FLT, DEMP and FMT to L,
and bridge XSMT (H3) to H (as on the kit board). Its SCK pad is often bridged to GND on the
front: keep that bridge for the internal mode, remove it for the low-jitter mode.

## 5. Block diagrams

```
INTERNAL CLOCK MODE (default): ESP32-S3 is I2S master, PLL_F160M / (13 + 1/48) -> MCLK. Kit board wiring.

                       +--------------------------------+
   USB-C ==============| ESP32-S3 SuperMini             |         +-------------------+
                       |  GPIO7  BCK    3.072 MHz  ---->|---+---->| SCK    INMP441    |<== mic (L slot)
                       |  GPIO8  LRCK      48 kHz  ---->|---|-+-->| WS     (L/R = GND)|
                       |  GPIO10 DIN               <----|---|-|---| SD                |
                       |                                |   | |   +-------------------+
                       |                                |   | |   +-------------------+
                       |                                |   +-|-->| BCK               |
                       |                                |   | +-->| LCK   PCM5102A    |==> line out L/R
                       |  GPIO9  DOUT              ---->|---|-|-->| DIN   (SCK = GND, |
                       |                                |   | |   |  XSMT = H)        |
                       |                                |   | |   +-------------------+
                       |                                |   +-|-->| BCLK  MAX98357A   |==> speaker
                       |                                |     +-->| LRC               |
                       |  GPIO9  DOUT (same line)  ---->|-------->| DIN               |
                       |  GPIO11 AMP SD            ---->|-------->| SD (high = on)    |
                       |                                |         +-------------------+
                       |  GPIO21 MCLK -> PCM1808 SCKI (only if a PCM1808 replaces the mic on GPIO10)
                       |  GPIO12/13  I2C  ---> OLED     |
                       |  GPIO4/5/6  <--- EC11 A/B/SW   |
                       +--------------------------------+
```

```
LOW-JITTER MODE (CONFIG_TWOFOLD_CLOCK_EXT_OSC): 12.288 MHz XO, PCM1808 is master, ESP32-S3 + PCM5102A are slaves

     +-------------+   33R    +-------------------+
     | 12.288 MHz  |---/\/\---| SCKI              |
     |  XO (3V3)   |          |      PCM1808      |<== line in L/R
     |             |   33R    |  (master 256fs,   |
     |             |---/\/\-+ |   MD1:0 = 11)     |
     +-------------+        | |  BCK  LRC  DOUT   |
                            | +---+----+-----+----+
                            |     |    |     |
   +------------------------|-----|----|-----|-----+
   | ESP32-S3 SuperMini     |     |    |     |     |
   |  GPIO7 BCK  (in)  <----|-----+    |     |     |     GPIO21 (MCLK): not connected
   |  GPIO8 LRCK (in)  <----|-----|----+     |     |
   |  GPIO10 DIN       <----|-----|----|-----+     |
   |  GPIO9 DOUT  ----+     |     |    |           |
   |  XSMT = H ---+   |     |     |    |           |
   +--------------|---|-----|-----|----|-----------+
                  |   |     |     |    |
              +---v---v-----v-----v----v----+
              | XSMT DIN   SCK   BCK  LCK   |
              |  PCM5102A (slave,           |==> line out L/R
              |  SCK from XO: no PLL)       |
              +-----------------------------+
```

Low-jitter mode notes: one oscillator output drives two loads through **separate 33 Ω** series resistors placed at the oscillator (star, not daisy-chain). BCK and LRCK come from the PCM1808 and fan out to the ESP32-S3 and the PCM5102A; the firmware configures I2S0 TX+RX as slave. Switching modes = rewire MD0/MD1, SCKI, PCM5102A SCK and rebuild with `CONFIG_TWOFOLD_CLOCK_EXT_OSC`.
