willbearfruits/twofold/enclosure/renders/assembly.png

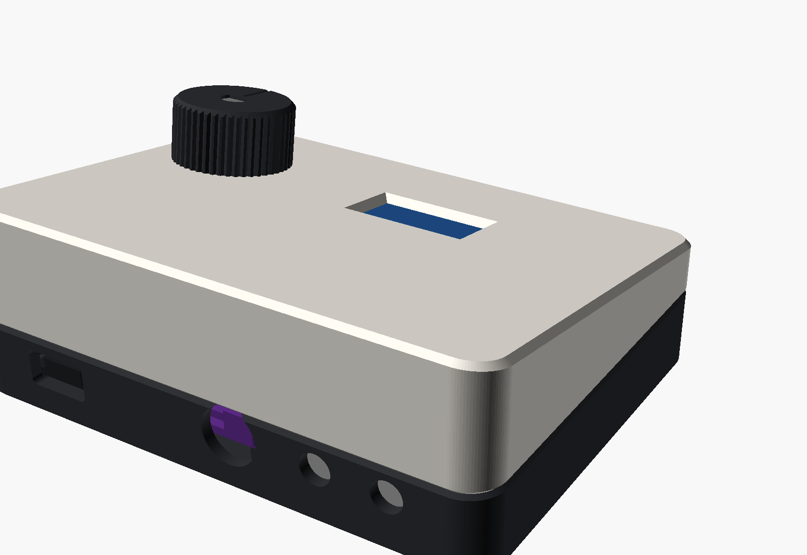
enclosure/renders/assembly.png
