willbearfruits/twofold/enclosure/renders/print_knob.png

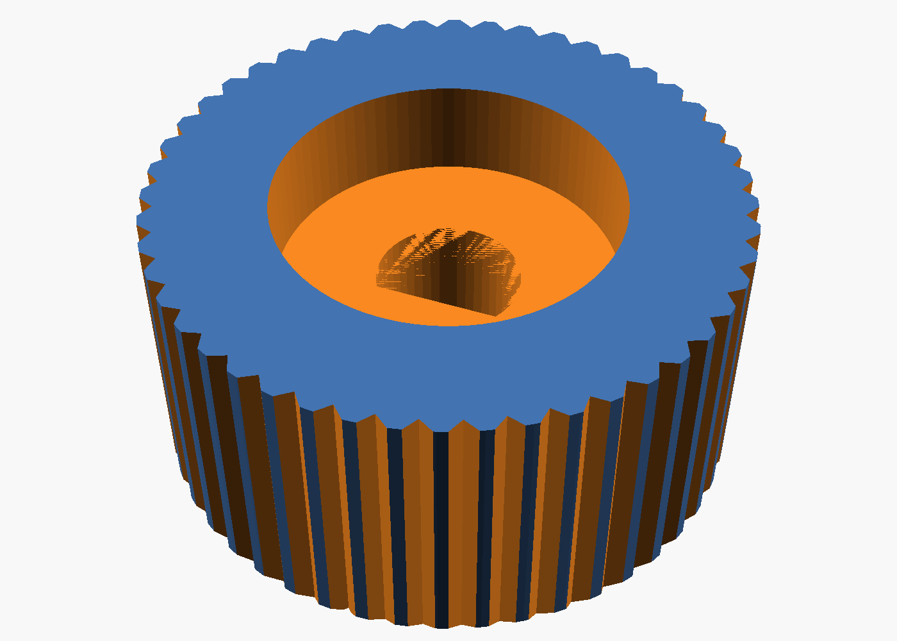
enclosure/renders/print_knob.png
