willbearfruits/twofold/enclosure/renders/print_lid.png

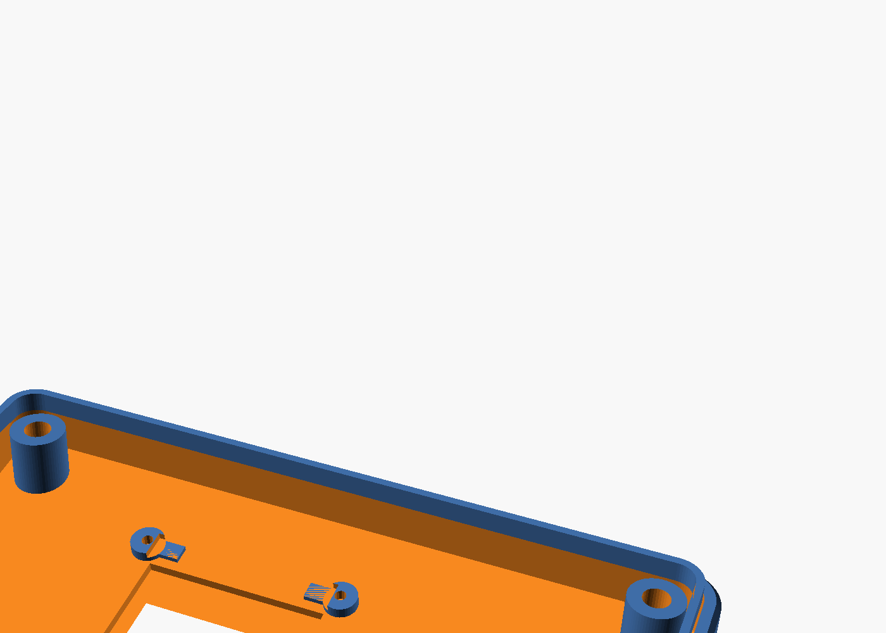
enclosure/renders/print_lid.png
