willbearfruits/twofold/docs/test-results/dsp_tests.md

# DSP host test results

Generated by `host/dsp_tests/run.sh`. Every test drives the real engine (`firmware/components/dsp`) through its public API with the real parameter table.

| result | test |
|---|---|
| PASS | eq cfg0: max /measured - analytic RBJ/ = 0.0124 dB (at 20 Hz), limit 0.05 dB |
| PASS | eq cfg1: max /measured - analytic RBJ/ = 0.0247 dB (at 21 Hz), limit 0.05 dB |
| PASS | eq cfg2: max /measured - analytic RBJ/ = 0.0025 dB (at 31 Hz), limit 0.05 dB |
| PASS | limiter: peak out 0.966051 (-0.300 dBFS) with +12 dB overs, ceiling -0.30 dBFS |
| PASS | limiter below threshold: output bit-identical to limiter-off (lookahead 0 samples) |
| PASS | reverb decay 1.0 s: measured RT60 0.96 s (3.8 % off), L/R tail correlation -0.015, first output 30.0 ms (pre-delay 20 ms) |
| PASS | reverb decay 2.2 s: measured RT60 2.02 s (8.1 % off), L/R tail correlation -0.010, first output 30.0 ms (pre-delay 20 ms) |
| PASS | reverb decay 6.0 s: measured RT60 5.17 s (13.8 % off), L/R tail correlation -0.006, first output 30.0 ms (pre-delay 20 ms) |
| PASS | delay sync=FREE mode=STEREO: L@12049 L@24050, spacing 12001 (expect 12000), fixed engine latency 49 samples; successive same-side tap ratio -6.14 dB |
| PASS | delay sync=FREE mode=PING-PONG: L@12049 R@24050 L@36050, spacing 12001/12000 (expect 12000), fixed engine latency 49 samples; successive same-side tap ratio -11.89 dB |
| PASS | delay sync=1/4 mode=PING-PONG: L@24049 R@48050 L@72050, spacing 24001/24000 (expect 24000), fixed engine latency 49 samples; successive same-side tap ratio -11.89 dB |
| PASS | delay sync=1/8 D mode=STEREO: L@18049 L@36050, spacing 18001 (expect 18000), fixed engine latency 49 samples; successive same-side tap ratio -6.14 dB |
| PASS | saturation drive 12 dB, 5000 Hz -12 dBFS: worst alias -137.8 dBc (2x OS) vs -66.5 dBc naive tanh; in-band THD -24.7 dB |
| PASS | saturation drive 12 dB, 9000 Hz -12 dBFS: worst alias -142.3 dBc (2x OS) vs -45.1 dBc naive tanh; in-band THD -31.5 dB |
| PASS | saturation drive 6 dB, 9000 Hz -6 dBFS: worst alias -142.0 dBc (2x OS) vs -45.1 dBc naive tanh; in-band THD -31.5 dB |
| PASS | saturation drive 12 dB, 13000 Hz -12 dBFS: worst alias -81.0 dBc (2x OS) vs -23.5 dBc naive tanh; in-band THD -240.0 dB |
| INFO | saturation EXTREME corner (informational): drive 24 dB, 9000 Hz -6 dBFS: worst alias -22.0 dBc (2x OS) vs -17.6 dBc naive tanh |
| INFO | saturation EXTREME corner (informational): drive 24 dB, 13000 Hz -6 dBFS: worst alias -18.7 dBc (2x OS) vs -10.0 dBc naive tanh |
| PASS | EQ LF precision (20 Hz shelf +18, 30 Hz Q10 +18, 60 Hz Q8 -18): engine vs ideal double filter = -119.1 dBFS rms, 95.1 dB below the -24.0 dBFS signal (TDF-II float biquads measured -79.1 dBFS here; limit 90 dB below) |
| PASS | ISO 226 table: /Lp(1 kHz) - phon/ max 0.012 dB; Lp(100 Hz, 40 phon) = 64.9 dB SPL (ISO 226:2003 ~64) |
| PASS | loudness @ volume -40 dB (83 -> 43 phon): gain 50 Hz +15.5 dB (ISO 226: +16.2), 1 kHz +0.02 dB, 10 kHz +2.4 dB (ISO 226: +2.6) |
| PASS | crossfeed with mono input: block output bit-identical (0 mismatches); engine output within 1.50 LSB (dither only, latency 49) |
| PASS | crossfeed L-only input, feed 4.5 dB, fc 700 Hz: cross level 100 Hz -4.9 dB (expect -4.5), 10 kHz -31.2 dB |
| PASS | TPDF dither (aligned for 49-sample latency): error mean -0.0001 LSB, rms 0.526 LSB (theory 0.500), L/R correlation 0.0001, /e/ <= 2 LSB: yes |
| PASS | record path at unity gain (STEREO): 0 mismatching samples of 96000 (bit-exact) |
| PASS | DAC path at unity, flat chain, 24-bit input: error rms 0 LSB over 383902 samples (bit-perfect) |
| PASS | click test: 84 parameters stepped def->max->min->def under a 1 kHz+100 Hz tone; worst 1 ms HF spike 3.15 dB over its neighbourhood (sat.drive, max->min), limit 6 dB |
| PASS | preset crossfades: worst 1 ms HF spike 0.0 dB over its +-10 ms neighbourhood (limit 6 dB); soft mute 0.0 dB, reaches digital silence: yes |
| PASS | host benchmark (x86, informational): full chain incl. all effects runs 98x realtime (213 ns/frame) |

## Host stage breakdown (x86, relative share of engine time, all effects on)

| stage | % of engine time |
|---|---|
| INPUT | 4.3 |
| EQ | 1.6 |
| SAT | 23.1 |
| CHORUS | 9.8 |
| DELAY | 7.8 |
| REVERB | 23.2 |
| COMP | 14.1 |
| OUTPUT | 3.5 |
| DITHER | 12.5 |

## Plots

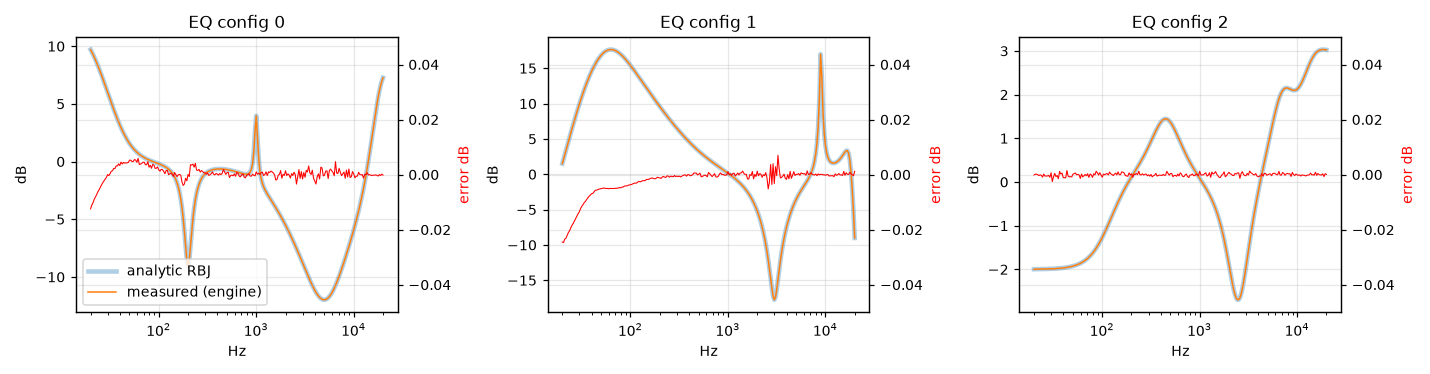
[picture p25: docs/test-results/eq_response.png]
eq_response


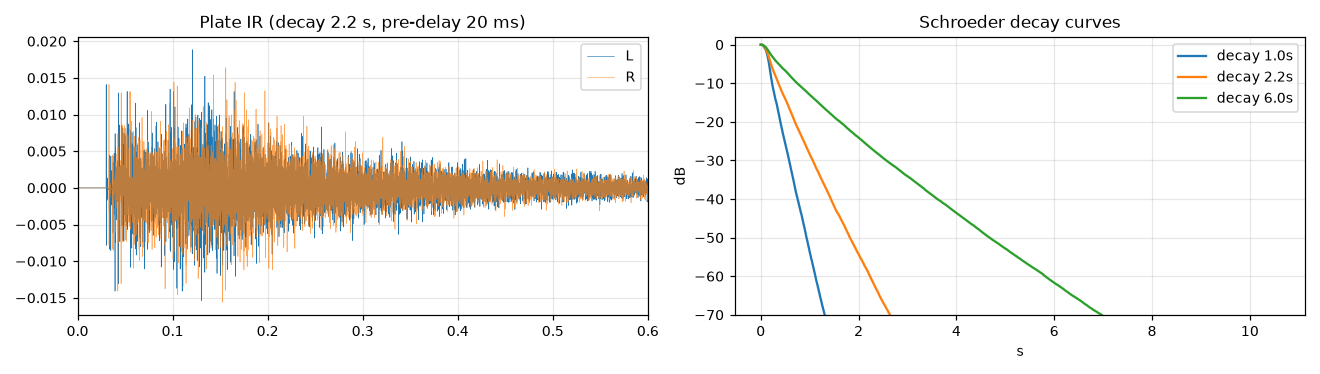
[picture p26: docs/test-results/reverb.png]
reverb


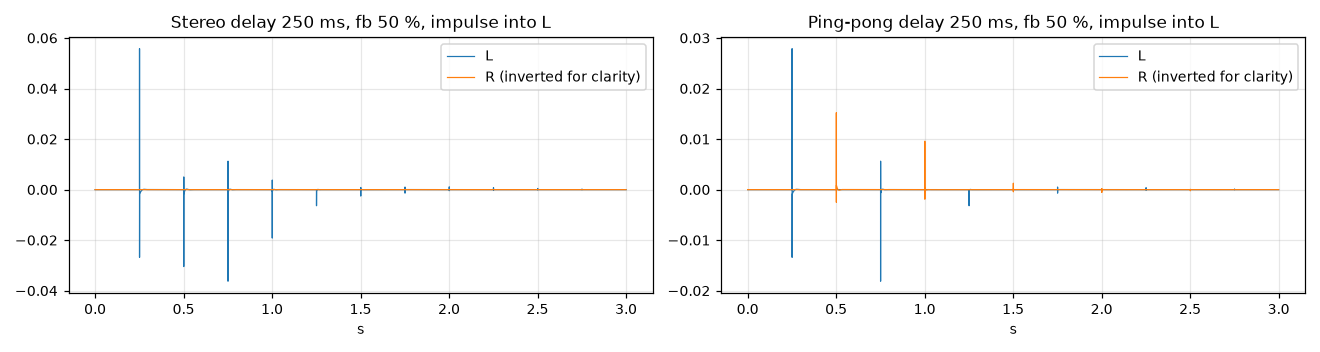
[picture p27: docs/test-results/delay.png]
delay


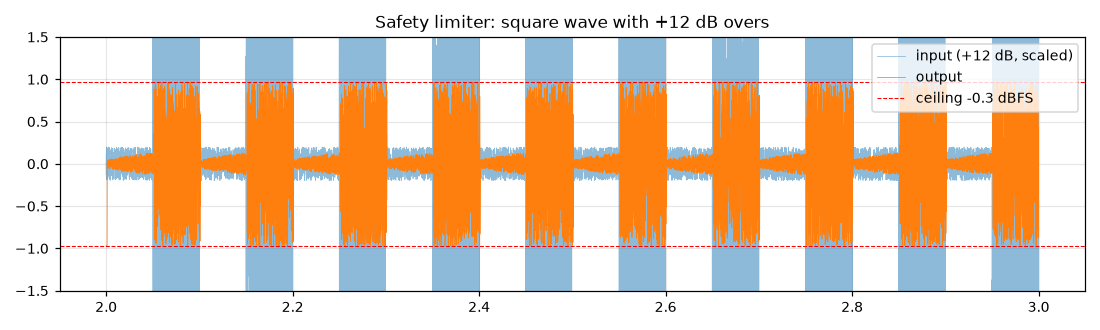
[picture p28: docs/test-results/limiter.png]
limiter


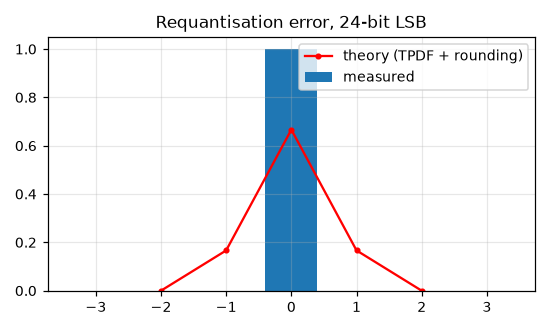
[picture p29: docs/test-results/dither.png]
dither


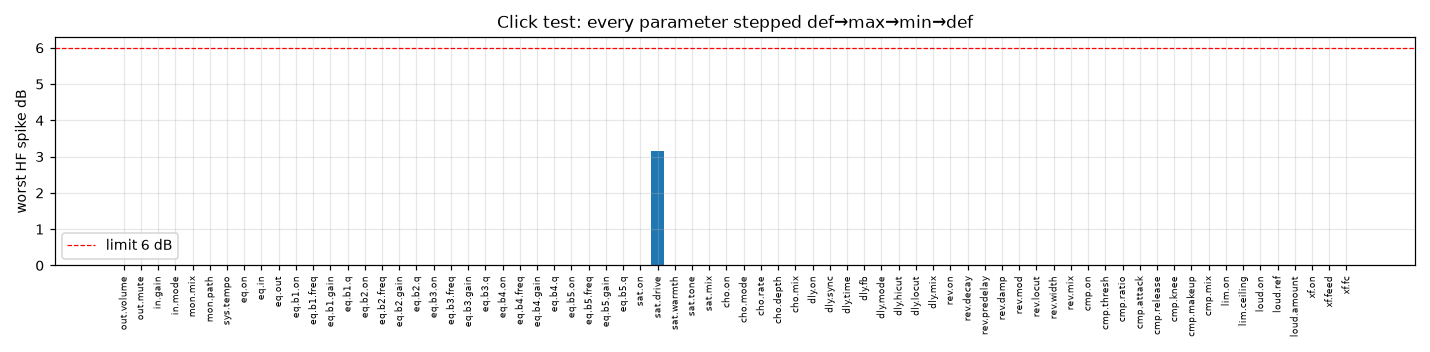
[picture p30: docs/test-results/clicks.png]
clicks
