willbearfruits/twofold/docs/test-results/raw/delay_ir_sync0_pp0.csv

t | L | R
0.00000 | 0.000000 | 0.000000
0.00008 | 0.000000 | 0.000000
0.00017 | 0.000000 | 0.000000
0.00025 | 0.000000 | 0.000000
0.00033 | 0.000000 | 0.000000
0.00042 | 0.000000 | 0.000000
0.00050 | 0.000000 | 0.000000
0.00058 | 0.000000 | 0.000000
0.00067 | 0.000000 | 0.000000
0.00075 | 0.000000 | 0.000000
0.00083 | -0.000000 | -0.000000
0.00092 | 0.000000 | 0.000000
0.00100 | 0.000000 | 0.000000
0.00108 | -0.000000 | 0.000000
0.00117 | 0.000000 | 0.000000
0.00125 | 0.000000 | 0.000000
0.00133 | 0.000000 | 0.000000
0.00142 | 0.000000 | 0.000000
0.00150 | 0.000000 | -0.000000
0.00158 | -0.000000 | 0.000000
0.00167 | 0.000000 | 0.000000
0.00175 | 0.000000 | 0.000000
0.00183 | -0.000000 | 0.000000
0.00192 | 0.000000 | -0.000000
0.00200 | 0.000000 | 0.000000
0.00208 | 0.000000 | 0.000000
0.00217 | 0.000000 | 0.000000
0.00225 | 0.000000 | 0.000000
0.00233 | 0.000000 | -0.000000
0.00242 | 0.000000 | 0.000000
0.00250 | 0.000000 | 0.000000
0.00258 | 0.000000 | 0.000000
0.00267 | 0.000000 | 0.000000
0.00275 | 0.000000 | 0.000000
0.00283 | -0.000000 | 0.000000
0.00292 | 0.000000 | 0.000000
0.00300 | -0.000000 | 0.000000
0.00308 | 0.000000 | 0.000000
0.00317 | 0.000000 | 0.000000
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
