willbearfruits/twofold/docs/test-results/raw/dither_hist.csv

lsb | count
-3 | 0
-2 | 0
-1 | 0
0 | 383902
1 | 0
2 | 0
3 | 0
