willbearfruits/twofold/docs/test-results/raw/eq_cfg0.csv

freq | measured_db | target_db
20.000 | 9.70297 | 9.71538
20.584 | 9.49992 | 9.51096
21.185 | 9.28474 | 9.29493
21.804 | 9.05860 | 9.06757
22.440 | 8.82116 | 8.82924
23.096 | 8.57322 | 8.58046
23.770 | 8.31565 | 8.32185
24.464 | 8.04868 | 8.05416
25.179 | 7.77366 | 7.77825
25.914 | 7.49137 | 7.49508
26.670 | 7.20276 | 7.20568
27.449 | 6.90892 | 6.91118
28.251 | 6.61121 | 6.61276
29.076 | 6.31070 | 6.31166
29.925 | 6.00917 | 6.00913
30.799 | 5.70611 | 5.70646
31.698 | 5.40529 | 5.40492
32.623 | 5.10701 | 5.10579
33.576 | 4.81173 | 4.81030
34.557 | 4.52190 | 4.51964
35.566 | 4.23716 | 4.23495
36.604 | 3.96045 | 3.95727
37.673 | 3.69075 | 3.68758
38.773 | 3.43064 | 3.42674
39.905 | 3.17885 | 3.17552
41.071 | 2.93909 | 2.93455
42.270 | 2.70823 | 2.70435
43.504 | 2.48977 | 2.48532
44.774 | 2.28187 | 2.27771
46.082 | 2.08597 | 2.08167
47.427 | 1.90150 | 1.89722
48.812 | 1.72871 | 1.72427
50.238 | 1.56791 | 1.56261
51.705 | 1.41721 | 1.41198
53.215 | 1.27675 | 1.27199
54.768 | 1.14698 | 1.14222
56.368 | 1.02767 | 1.02219
58.014 | 0.91664 | 0.91135
59.708 | 0.81364 | 0.80917
61.451 | 0.72097 | 0.71504
63.246 | 0.63208 | 0.62840
65.092 | 0.55246 | 0.54863
66.993 | 0.47928 | 0.47517
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
