willbearfruits/twofold/(commit log)

2026-10-03 Plan and shared contracts: params model, DSP/UI/storage/net/BLE interfaces, board config
2026-10-03 Tools: clock jitter analysis, loopback measurement suite, wiring generator; PLAN clock rationale corrected
    [clock_jitter.py, gen_wiring.py, loopback.py]
2026-10-04 Firmware platform, DSP engine and host test-suite
    - Full ESP-IDF build: audio (I2S full duplex, both clock modes), usbdev (TinyUSB UAC2+MIDI),
    display, input, storage, led, net, ble, ui, gfx, dsp
    - Reverb tank at 24 kHz (half-band decimate/interpolate): ~73 KB instead of 146 KB internal RAM;
    per-line allocation with reserve-aware PSRAM spill
    - Two-stage parameter smoother, interpolated saturation tone/tilt coefficients (click-free)
    - host/dsp_tests: EQ vs RBJ, limiter ceiling + bit-transparency, reverb RT60, delay taps,
    saturation aliasing, TPDF dither, bit-perfect paths, click test over all 78 params, presets
    [delay_ir_sync0_pp0.csv, delay_ir_sync0_pp1.csv, delay_ir_sync2_pp1.csv, delay_ir_sync6_pp0.csv, dither_hist.csv, eq_cfg0.csv, eq_cfg1.csv, eq_cfg2.csv]
2026-10-04 Enclosure: parametric OpenSCAD wedge (tray + lid + knob), collision checks, STLs, renders
    [twofold.scad, twofold_knob.stl, twofold_lid.stl, twofold_tray.stl]
2026-10-05 Retarget to ESP32-S3 SuperMini with the kit/gesture-recorder wiring
    I2S 7/8/9/10, I2C 12/13, encoder 4/5/6, MAX98357A enable on 11, RGB LED 48,
    PCM1808 MCLK on spare 21. XSMT is bridged high on the kit, so output enables
    are optional per board. Wiring doc regenerated; README/PLAN/enclosure notes updated.
2026-10-05 WiFi reboot: bigger net_mgr stack, PHY TX power capped from power-on, reset diagnostics
    - net_mgr task stack 4 KB -> 8 KB (netif/wifi/mdns/httpd init ran on it)
    - CONFIG_ESP_PHY_MAX_WIFI_TX_POWER=11: the start-up calibration no longer transmits at
    20 dBm before the runtime cap applies (brownout on small 3V3 regulators)
    - bootdiag: reset reason (brownout/crash/watchdog) + RTC breadcrumb of the last WiFi/BLE
    step, shown as a toast on the OLED after the next boot
2026-10-05 WiFi crash (LoadProhibited in ieee80211_hostap_attach): free more internal RAM, guard, heap in crumbs
    - DSP internal reserve 96 -> 140 KB (more reverb delay lines spill to PSRAM)
    - WiFi static RX buffers 8 -> 6
    - refuse WiFi start below 56 KB internal free (no crash, error shown)
    - bootdiag crumbs record internal free/largest block; report shows heap stats
    [audio.c]
2026-10-08 USB-MIDI SysEx service channel: reboot-to-bootloader (no BOOT button), status report
    - usbdev: SysEx reassembly for manufacturer 0x7D, usb_midi_send_sysex, usbdev_reboot_to_bootloader
    (detach, pads back to USB-Serial/JTAG, force ROM download boot, restart)
    - main/hostlink.c: 01 crash report, 03 status (CPU per DSP block, xruns, FIFO/feedback, heap), 7E BOOT
    - tools/flash.sh (hands-free flashing), tools/twofold_status.sh, shared twofold_sysex.sh
    [usbdev.c, usbdev.h]
2026-10-08 Reboot-to-bootloader: re-enable the USJ clock IDF gated at boot, SE0 detach, wait for bus reset; crumbs
    [usbdev.c]
2026-10-08 DSP CPU 128% -> 71% (all effects, measured on device)
    Root cause: ESP-IDF builds with -fno-builtin-memcpy, so the memcpy-based float punning in
    dsp_math.h (abs, flush, log2, exp2, meters) became a ROM call per sample. Use __builtin_memcpy
    and __builtin_fabsf (abs.s). Also: params re-read only on change (+ every 8th block), section-major
    half-band filters, 12 KB audio stack, on-device sub-stage profiling (SysEx 07), interrupts-masked
    profile (SysEx 05), MHz in the status report.
2026-10-08 DSP CPU 71% -> 53% with every effect on (measured on device), radios on or off
    - saturation 2x oversampling by default (Kconfig: 4x option); musical-drive aliasing unchanged
    (-138..-152 dBc), extreme 24 dB drive on loud HF tones -19..-22 dBc (4x: -33..-47)
    - SAT_LATENCY corrected to the measured chain delay (2x: 2, 4x: 3; was 5)
    - chorus: mid/side lines, one tap per voice for CHORUS/ENSEMBLE (Juno/ensemble style, stereo
    vibrato kept), incremental tap positions, LFOs only for active modes
    - half-band: both polyphase paths per loop; reverb mono decimator
    - SysEx 09/0A: WiFi/BLE on/off for measurements (WiFi AP uses ~96 KB internal RAM)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
    [delay_ir_sync0_pp0.csv, delay_ir_sync0_pp1.csv, delay_ir_sync2_pp1.csv, delay_ir_sync6_pp0.csv, dither_hist.csv, eq_cfg0.csv, eq_cfg1.csv, eq_cfg2.csv]
2026-10-08 README/PLAN: measured CPU on the board (52.6 % all effects), the fixes, WiFi RAM limitation
2026-10-08 Loudness (ISO 226), crossfeed, SVF/biquad EQ, web API over WebUSB, WiFi+BLE together
    - dsp: loudness compensation following the volume target, BS2B-style crossfeed (mono bit-exact),
    trapezoidal SVF for low/narrow EQ bands (LF precision -79 -> -119 dBFS vs the ideal filter)
    - usb: vendor interface + BOS/WebUSB + MS OS 2.0 (WinUSB); EP0 and vendor EP 32 B to fit the DWC2 FIFO
    - net: transport-independent API dispatcher (net_api_dispatch), net_usb.c framing task; web app
    'Connect over USB' (WebUSB); tools/twofold_usb.py (libusb), tools/99-twofold.rules
    - memory: PSRAM task stacks, spectrum ring in PSRAM, params table in flash, WiFi/BLE trims; guards.
    Measured: WiFi AP + BLE run together w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
    [eq_cfg0.csv, eq_cfg1.csv, eq_cfg2.csv]
2026-10-08 Production: OTA rollback with audio health confirmation, ctrl stack 6 KB, zero boot-time counter artifacts, flash-stall accounting, release bundle, tester quick start, loopback split-device mode
    [audio.c, audio.h, loopback.py]
2026-10-08 Fix audible crunch with CPU-heavy effects: one block of TX lead by default (v1.0.2)
    The write for block k landed in the slot right after the playing one; the margin was only ever enough because a
    boot-time ring overflow (the I2S log line printed after enable) accidentally left writes one slot ahead. v1.0.0
    removed that accident. Also: /api/tap diagnostic, loopback split mode, host render/crunch tests, lead in status.
    [audio.c, dsp_tests.c]
2026-10-11 Prepare for public launch: README, project page, editor and flasher on Pages, licence
    - README: plain-language first screen (what it is, tour GIF, links, what you do
    with it), What it does, Get one (ask / workshop / build), Flash it, Status;
    the technical documentation kept below it, with the enclosure's S3-Zero origin,
    the OTA timings (20 s / 3 min) and the hosted editor noted.
    - docs/index.html: project page from the Serious S.H.I.T. template (amber accent),
    with the UI tour as a 1.9 MB MP4 instead of the 10 MB GIF.
    - docs/editor/: the v1.0.2 web editor, served over https so WebUSB works.
    - docs/flash/: ESP Web Tools manifest and the v1.0.2 full image (1.5 MB).
    - LICENSE (GPL-3.0 t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
